CIJE-STEM/Spiromatic-/curriculum/spiromatic_teacher_answer_key.docx

THE SPIROMATIC — DRAWING WITH MATH

Teacher Guide & Challenge Answer Key

Companion to the “Drawing with Math” slide deck, the spiromatic_shapes.ino sketch, and the on-screen simulator (spiromatic_simulator.html). All challenge answers refer to the SHAPE recipes in the sketch.

# Before class — 5-minute setup

- Files students need: spiromatic_shapes.ino (Arduino IDE) and spiromatic_simulator.html (any browser, works offline).
- Recommended flow: test a recipe in the simulator first, then upload to the real machine. The simulator uses the same numbers as the sketch, so answers transfer directly.
- Timing note: one full drawing at stepDelay = 12 takes about 40 seconds per turn; the 20-turn mandala runs about 8 minutes. Plan accordingly — the wait is part of the show.
- The GIFs on slides 5–9, 12, 22 animate in slideshow mode (press F5). In edit view they show only their first frame.

# Challenge answer key

CHALLENGE 1 — WARM-UP

Make a 7-petal flower. Which number changes?

The petal dial — the number inside cos. In recipe 1:

distance = 1.0 + 0.4 * cos(3 * angle * DEG_TO_RAD); // change 3 → 7

Why it works: cos(7 × angle) completes 7 full wiggles per turn of the platter, so the pen pushes out 7 times = 7 petals. Common mistake: changing the 0.4 instead — that changes petal size, not count.

CHALLENGE 2 — WARM-UP

Make the petals twice as chunky.

Double the wave size: 0.4 → 0.8.

distance = 1.0 + 0.8 * cos(3 * angle * DEG_TO_RAD);

Watch for: at 0.8 the pen distance swings from 0.2 to 1.8, and the sketch clamps at 0.5–1.6, so the biggest petals flatten slightly at the tips. That's a feature — ask students WHY the tips flatten (the safety clamp) and where in the code it lives.

CHALLENGE 3 — STRETCH

Turn the square into a triangle.

Corners every 120° instead of every 90° (360 ÷ 3 sides = 120). In the square recipe:

float slice = fmod(angle, 90.0) - 45.0; // square

float slice = fmod(angle, 120.0) - 60.0; // triangle

Important follow-up: triangle corners reach 2× out (vs 1.41× for the square), so the arm swings much harder. Students should also slow the platter (stepDelay 15–20) or the servo will round off the corners — connect this to the “fewer corners = bigger pushes” slide.

CHALLENGE 4 — STRETCH

Squash the ellipse: eccentricity 0.2, then 0.6.

distance = 0.9 / (1.0 + e * cos(angle * DEG_TO_RAD)); // e = eccentricity

- e = 0.2 → nearly a circle, gently off-center (like Earth's orbit, e ≈ 0.017)
- e = 0.6 → a long squashed oval; the pen sweeps in dramatically fast on one side (like a comet)

The astronomy hook: this is the actual polar equation of an orbit. The platter's center is the Sun, sitting at one focus — not the middle — of the ellipse. Kepler's first law, drawn in marker.

CHALLENGE 5 — BOSS

With 6.5 petals, how many turns until the pattern repeats?

Answer: 2 turns (and the pattern has 13 petal positions).

The math: the pattern repeats when (petal number × turns) is a whole number. 6.5 × 2 = 13 ✓. For 6.1 petals: 6.1 × 10 = 61, so it takes 10 turns and lands on 61 distinct petal positions — that's why 6.1 weaves a denser mandala than 6.5.

General rule (for the curious): write the petal number as a fraction in lowest terms (6.5 = 13/2, 6.1 = 61/10). The denominator is the number of turns; the numerator is the number of petal positions.

Run the test: in the simulator, mandala shape with petals = 6 gives 6.1 → watch the turn counter; the pattern visibly closes at turn 10 but keeps darkening afterward.

CHALLENGE 6 — BOSS (OPEN-ENDED)

Invent recipe 7.

Any rule angle → distance is valid. Grade on: (1) the rule stays inside the 0.5–1.6 clamp most of the time, (2) the student can predict what it will draw BEFORE running it, (3) they can explain the rule in one sentence.

Ideas to seed stuck students:

- 1 + 0.2*cos(3*a) + 0.2*cos(5*a) — two waves added = layered flower-in-flower
- 1 + 0.4*abs(cos(2*a)) — absolute value makes pointy petals
- 1 + random(-20, 20)/100.0 — jittery “scribble ring” (ties to the Generative Art extension)
- 1 + 0.4*cos(3*a)*cos(a/2) — petals that swell and shrink around the circle (needs 2 turns)

# The five real-world examples, in plain language

For the "SPIN + REACH runs the real world" slide (slide 13). Each explanation is written so you can say it out loud to a 9th grader — or a 5-year-old — without notes. The thread through all five: the Spiromatic turns angle + distance INTO a picture; most of these machines turn the world INTO angle + distance. Same two numbers, driven in opposite directions.

1 — RADAR & AIR TRAFFIC CONTROL

A radar antenna spins slowly around, and at every angle it shouts an invisible "hello!" and listens for the echo. A fast echo means something is close; a slow echo means it's far. So radar collects exactly the two numbers your students use — an angle and a distance — except the Spiromatic chooses the distance to make art, and radar discovers the distance to find planes. The round screen an air traffic controller watches is Spiromatic paper that airplanes draw themselves onto.

Connect it to the build: the spinning antenna is the platter; the echo time is the pen's reach.

2 — PLANETARY ORBITS

A planet's distance from the sun follows one rule: distance = p ÷ (1 + e × cos(angle)) — and that is character-for-character the ellipse recipe in the sketch. The sun doesn't sit in the middle of the oval; it sits off to one side, at a point called the focus — which is why the machine's ellipse looks lopsided around its center. That's not a flaw. That's Kepler's First Law.

Connect it to the build: when students change e from 0.2 to 0.6, they are turning Earth's nearly-round orbit into a comet's long dive. Challenge 4 is secretly an astronomy lesson.

3 — MUSIC, SOUND & WIFI

The arm plays "close... far... close... far..." — a smooth repeating wiggle. That wiggle is a wave, and cos is simply the instruction that makes it. WiFi is the same wiggle in invisible light, breathing about 2.4 billion times per second instead of 3 times per platter turn. And here's how WiFi actually says anything: the router changes the wiggle a tiny bit — taller here, quicker there — and your phone reads those changes as words and video.

Connect it to the build: changing 0.4 makes chunkier petals; changing 3 makes more of them. Changing the wiggle changes what comes out. For students it's art; for WiFi it's a YouTube video. Same trick, different audience.

4 — MEDICAL SCANNERS (CT & ULTRASOUND)

A CT scanner spins a camera-and-light pair in a full circle around the patient, taking one measurement at every angle. No single measurement shows anything useful — but a computer stitches all the angles together into a picture of the inside. Ultrasound is the pocket version: the probe sweeps a fan of angles and times echoes, radar for the body.

Connect it to the build: the scanner only works because it always knows exactly what angle it's at — which is stepCount, the "orange line is gold" idea from the code. Homing and step-counting are literally how hospital machines know where they're pointing.

5 — ROBOTS & SELF-DRIVING CARS

On the roof of a self-driving car sits a small spinning tower called lidar — a platter holding a laser tape-measure instead of a pen. Every angle, it measures the reach to whatever is out there: mailbox at 3 meters, dog at 8, truck at 20. Connect the dots and the car has drawn a picture of the street around it — a fresh drawing many times every second.

Connect it to the build: a lidar scan genuinely looks like a Spiromatic drawing where the shape is the neighborhood. Students who tuned a stepper to sweep smoothly have solved, in cardboard, the same problem lidar engineers solve in titanium.

# Quick troubleshooting during the lesson

- Motor buzzes but doesn't spin: stepDelay below 2 ms, or IN1–IN4 wired out of order. Fix the delay first — it's the usual cause.
- Corners look rounded: platter too fast for the servo. Raise stepDelay to 15–20 for polygons and stars.
- Shape drifts off-center between runs: students moved the arm by hand while the servo was off. Re-run — the sketch re-homes the servo in setup().
- Faint or skipping lines: see the pen-pressure reference sheet — felt-tip marker, floating sleeve, weight added gradually.

# Answers to in-deck questions

Slide 22 — “Which line would you change to make a heart?” Line 2, the recipe line. The heart is 0.5 + 0.5*(1 + cos(angle)) — one big bump per turn instead of three.

Slide 12 — “How many turns until 6.1 petals line up?” 10 turns (61 petal positions) — full working shown in Challenge 5 above.
