CIJE-STEM/Spiromatic-/images/spiromatic_math_use_cases.png

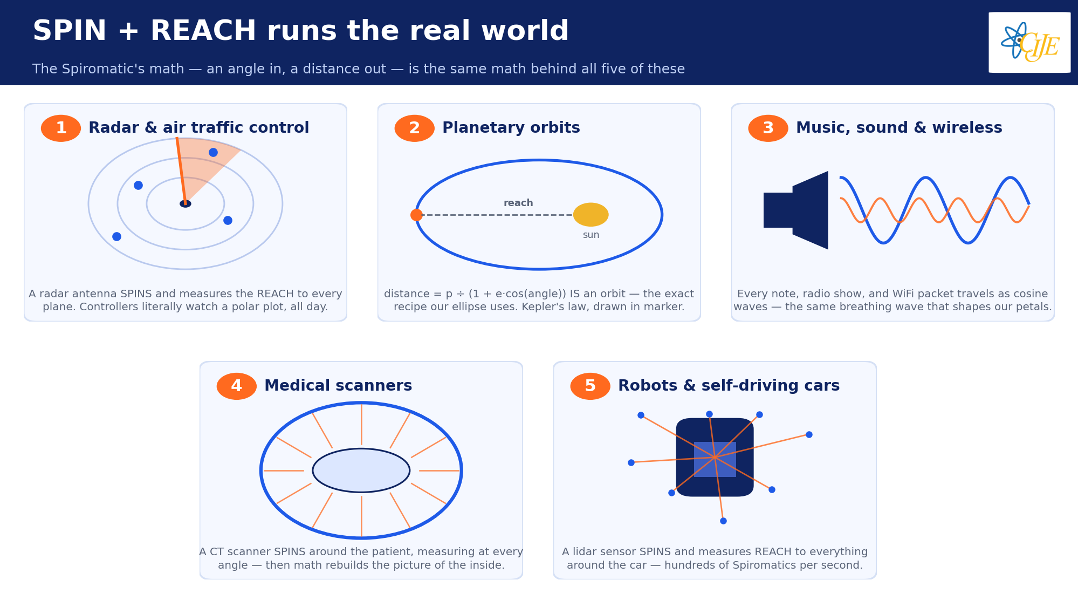
images/spiromatic_math_use_cases.png
