CIJE-STEM/Spiromatic-/(commit log)

2026-07-15 Add README and Arduino sketches
2026-07-15 Add CIJE logo to all materials
2026-07-22 Add files via upload
    Here is a version with two stepper motors and IR homing addon that will allow for cleaner more beautiful designs.
2026-07-22 Add code/ copies of Arduino sketches and simulator
2026-07-22 Add curriculum/ copies of teacher materials
2026-07-22 Add images/ copies of wiring diagrams and graphics
